ruchadave16/eclectronics/48037-0001/48037-0001.step

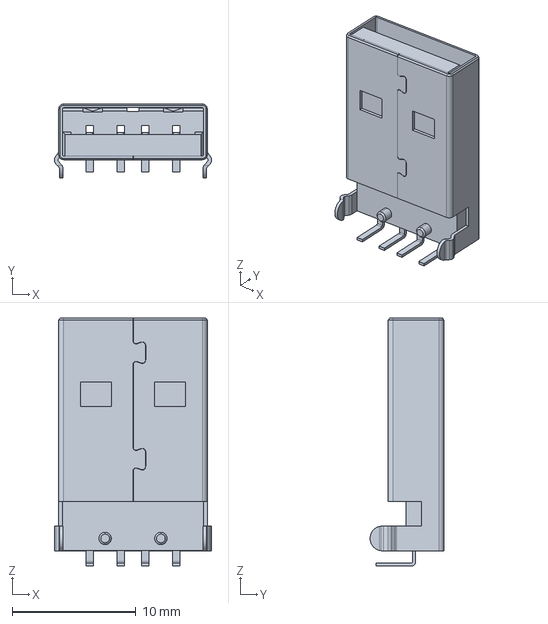
[picture p6: CAD file, 2022-09-15]
48037-0001/48037-0001.step
12.7 x 5.97 x 20.0 mm
