ruchadave16/eclectronics/Project1.asc

C2: cap; {wc(0.1uF, 0.05, 8)}
R1: res; {wc(10K, 0.01, 4)}
R2: res; {wc(10K, 0.01, 6)}
R3: res; {wc(10K, 0.01, 7)}
R4: res; {wc(698K, 0.01, 2)}
R5: res; {wc(10K, 0.01, 5)}
R6: res; {wc(3.01Meg, 0.01, 1)}
R7: res; {wc(909K, 0.01, 3)}
U1: opamprails
U2: vdd_alt
U3: vdd_alt
U4: opamprails
U5: vdd_alt
U6: vdd_alt
Vdd: vsource; 3.3V
Named nets: 0
.include engr2420.sub
.tran 0 20 5
.func wc(nom, tol, index) if (run==numruns, nom, if(binary(run, index), nom*(1+tol), nom*(1-tol)))
.func binary(run, index) floor(run/(2**index))-2*floor(run/(2**(index+1)))
.step param run 0 256 1
.param numruns=256
