ruchadave16/eclectronics/Project1.kicad_pcb

## KiCad design Project1.kicad_pcb (2022-09-16)

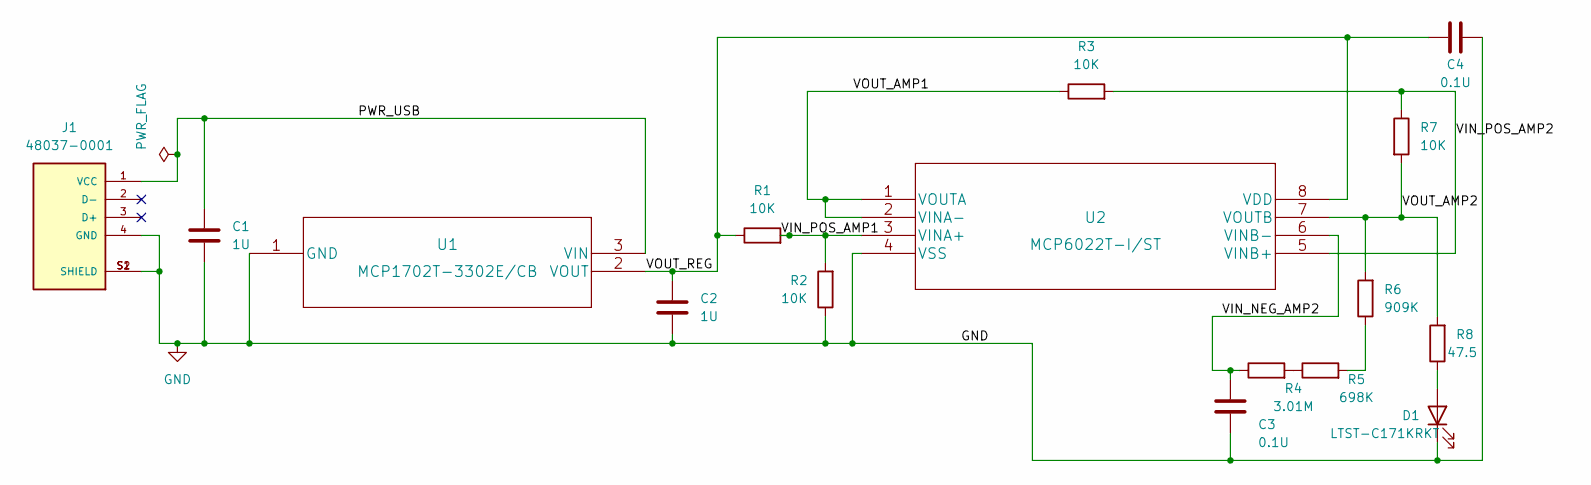
[picture p7: schematic Project1.kicad_sch]

Parts:
C1, C2: 1U; C_0603_1608Metric_Pad1.08x0.95mm_HandSolder
C3, C4: 0.1U; C_0603_1608Metric_Pad1.08x0.95mm_HandSolder
D1: LTST-C171KRKT; LED_0805_2012Metric_Pad1.15x1.40mm_HandSolder
J1: 48037-0001; MOLEX_48037-0001; PARTREV D
R1, R2, R3, R7: 10K; R_0603_1608Metric_Pad0.98x0.95mm_HandSolder
R4: 3.01M; R_0603_1608Metric_Pad0.98x0.95mm_HandSolder
R5: 698K; R_0603_1608Metric_Pad0.98x0.95mm_HandSolder
R6: 909K; R_0603_1608Metric_Pad0.98x0.95mm_HandSolder
R8: 47.5; R_0603_1608Metric_Pad0.98x0.95mm_HandSolder
U1: MCP1702T-3302E/CB; SOT-23A_MC_MCH
U2: MCP6022T-I/ST; TSSOP8_MC_MCH

Connections:
/PWR_USB: C1.2, J1.1 (VCC), U1.3 (VIN)
/VIN_NEG_AMP2: C3.2, R4.1, U2.6 (VINB-)
/VIN_POS_AMP1: R1.2, R2.2, U2.3 (VINA+)
/VIN_POS_AMP2: R3.2, R7.1, U2.5 (VINB+)
/VOUT_AMP1: R3.1, U2.1 (VOUTA), U2.2 (VINA-)
/VOUT_AMP2: R6.2, R7.2, R8.2, U2.7 (VOUTB)
/VOUT_REG: C2.2, C4.1, R1.1, U1.2 (VOUT), U2.8 (VDD)
GND: C1.1, C2.1, C3.1, C4.2, D1.1 (K), J1.4 (GND), J1.S1 (SHIELD), J1.S2 (SHIELD), R2.1, U1.1 (GND), U2.4 (VSS)
unnamed: D1.2 (A), R8.1
unnamed: R4.2, R5.1
unnamed: R5.2, R6.1

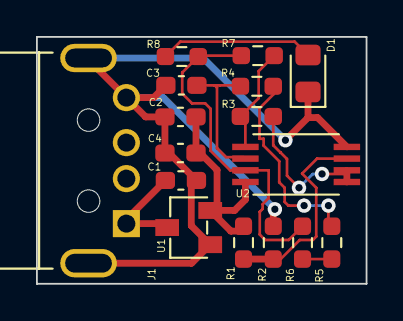
[picture p8: board Project1.kicad_pcb from above]

Board: 2 copper layers, 18.3 x 13.7 mm, 16 parts (0 on the bottom side), 11 nets.
