ruchadave16/eclectronics/(commit log)

2022-09-15 Add footprints
    [48037-0001.step]
2022-09-15 Add KiCad Designs
    [Project1.kicad_pcb, Project1.kicad_sch]
2022-09-15 Add missing KiCad file
2022-09-16 Fix footprint for USB Connector
2022-09-16 Add report and necessary files
    [Project1.kicad_pcb, Project1.kicad_sch]
2022-09-16 Add Bill of Materials
    [Project1.csv]
2022-09-16 Rename files to be more clear
    [bill-of-materials.csv]
2022-09-16 Fix schematic errors
    [Project1.kicad_sch]
2022-09-16 Fix trace errors in pcb
    [Project1.kicad_pcb]
